davisjp1822/Analog_Persistence/README.md

# Analog_Persistence
Educational board showing an industrial 4-20mA or 0-10V input using a MCP3424 A/D and AD8220 Diffamp

Purchase the complete board at the [ThreeML website](https://www.three-ml.com/product/analog-persistence/)
