davisjp1822/Analog_Persistence/BOM.xlsx

Sheet: BOM
Reference | Value | Characteristics | Description | MFN | Package ID | Source | Critical | Notes | Populate | MPN | Library | Library Ref
C101 | 10uF | X | 10ÂµF Â±10% 16V Ceramic Capacitor X7R 0805 (2012 Metric) | Samsung Electro-Mechanics America Inc. | 805 | Digikey | Y | X |  | CL21B106KOQNNNG | device | C_Small
C102 | 10uF | X | 10ÂµF Â±10% 16V Ceramic Capacitor X7R 0805 (2012 Metric) | Samsung Electro-Mechanics America Inc. | 805 | Digikey | Y | X |  | CL21B106KOQNNNG | device | C_Small
C103 | 0.1uF | 0.1uF 0805 capacitor | 0.10ÂµF 50V Ceramic Capacitor X7R 0805 | AVX Corporation | 805 | Digikey | Y | X |  | 08055C104KAT2A | device | C_Small
C104 | 0.1uF | 0.1uF 0805 capacitor | 0.10ÂµF 50V Ceramic Capacitor X7R 0805 | AVX Corporation | 805 | Digikey | Y | X |  | 08055C104KAT2A | device | C_Small
C105 | 10uF | X | 10ÂµF Â±10% 16V Ceramic Capacitor X7R 0805 (2012 Metric) | Samsung Electro-Mechanics America Inc. | 805 | Digikey | Y | X |  | CL21B106KOQNNNG | device | C_Small
C106 | 10uF | X | F931A106KAA | AVX Corporation | 1206 (3216 Metric) | Digikey | Y | X | 1 |  | device | CP1_Small
C107 | 10uF | X | 10ÂµF Â±10% 16V Ceramic Capacitor X7R 0805 (2012 Metric) | Samsung Electro-Mechanics America Inc. | 805 | Digikey | Y | X |  | CL21B106KOQNNNG | device | C_Small
C108 | 10uF | X | 10ÂµF Â±10% 16V Ceramic Capacitor X7R 0805 (2012 Metric) | Samsung Electro-Mechanics America Inc. | 805 | Digikey | Y | X |  | CL21B106KOQNNNG | device | C_Small
C109 | 10uF | X | 10ÂµF Â±10% 16V Ceramic Capacitor X7R 0805 (2012 Metric) | Samsung Electro-Mechanics America Inc. | 805 | Digikey | Y | X |  | CL21B106KOQNNNG | device | C_Small
C110 | 0.1uF | 0.1uF 0805 capacitor | 0.10ÂµF 50V Ceramic Capacitor X7R 0805 | AVX Corporation | 805 | Digikey | Y | X |  | 08055C104KAT2A | device | C_Small
C111 | 0.1uF | 0.1uF 0805 capacitor | 0.10ÂµF 50V Ceramic Capacitor X7R 0805 | AVX Corporation | 805 | Digikey | Y | X |  | 08055C104KAT2A | device | C_Small
C112 | 0.1uF | 0.1uF 0805 capacitor | 0.10ÂµF 50V Ceramic Capacitor X7R 0805 | AVX Corporation | 805 | Digikey | Y | X |  | 08055C104KAT2A | device | C_Small
C113 | 0.1uF | 0.1uF 0805 capacitor | 0.10ÂµF 50V Ceramic Capacitor X7R 0805 | AVX Corporation | 805 | Digikey | Y | X |  | 08055C104KAT2A | device | C_Small
C114 | 0.1uF | 0.1uF 0805 capacitor | 0.10ÂµF 50V Ceramic Capacitor X7R 0805 | AVX Corporation | 805 | Digikey | Y | X |  | 08055C104KAT2A | device | C_Small
C115 | 0.1uF | 0.1uF 0805 capacitor | 0.10ÂµF 50V Ceramic Capacitor X7R 0805 | AVX Corporation | 805 | Digikey | Y | X |  | 08055C104KAT2A | device | C_Small
C116 | 0.1uF | 0.1uF 0805 capacitor | 0.10ÂµF 50V Ceramic Capacitor X7R 0805 | AVX Corporation | 805 | Digikey | Y | X |  | 08055C104KAT2A | device | C_Small
C117 | 0.1uF | 0.1uF 0805 capacitor | 0.10ÂµF 50V Ceramic Capacitor X7R 0805 | AVX Corporation | 805 | Digikey | Y | X |  | 08055C104KAT2A | device | C_Small
C118 | 1nF HV | X | CAP CER 1000PF 1KV X7R 0805 | Johanson Dielectrics Inc. | 805 | Digikey | Y | X | 1 | 102R15W102KV4E | device | C_Small
C119 | 1nF HV | X | CAP CER 1000PF 1KV X7R 0805 | Johanson Dielectrics Inc. | 805 | Digikey | Y | X | 1 | 102R15W102KV4E | device | C_Small
C120 | 1nF HV | X | CAP CER 1000PF 1KV X7R 0805 | Johanson Dielectrics Inc. | 805 | Digikey | Y | X | 1 | 102R15W102KV4E | device | C_Small
C121 | 1nF HV | X | CAP CER 1000PF 1KV X7R 0805 | Johanson Dielectrics Inc. | 805 | Digikey | Y | X | 1 | 102R15W102KV4E | device | C_Small
C122 | 10uF | X | 10ÂµF Â±10% 16V Ceramic Capacitor X7R 0805 (2012 Metric) | Samsung Electro-Mechanics America Inc. | 805 | Digikey | Y | X |  | CL21B106KOQNNNG | device | C_Small
D101 | D_Schottky_Small_ALT | X | Diode Schottky 30V 500mA (DC) Surface Mount SOD-323 | ON Semiconductor | SOD-323 | Digikey | Y | X |  | NSR0530HT1GOSCT-ND | device | D_Schottky_Small_ALT
D102 | D_Schottky_Small_ALT | X | Diode Schottky 30V 500mA (DC) Surface Mount SOD-323 | ON Semiconductor | SOD-323 | Digikey | Y | X |  | NSR0530HT1GOSCT-ND | device | D_Schottky_Small_ALT
D103 | D_Schottky_Small_ALT | X | Diode Schottky 30V 500mA (DC) Surface Mount SOD-323 | ON Semiconductor | SOD-323 | Digikey | Y | X |  | NSR0530HT1GOSCT-ND | device | D_Schottky_Small_ALT
D104 | D_Schottky_Small_ALT | X | Diode Schottky 30V 500mA (DC) Surface Mount SOD-323 | ON Semiconductor | SOD-323 | Digikey | Y | X |  | NSR0530HT1GOSCT-ND | device | D_Schottky_Small_ALT
D105 | D_Schottky_Small_ALT | X | Diode Schottky 30V 500mA (DC) Surface Mount SOD-323 | ON Semiconductor | SOD-323 | Digikey | Y | X |  | NSR0530HT1GOSCT-ND | device | D_Schottky_Small_ALT
D106 | D_Schottky_Small_ALT | X | Diode Schottky 30V 500mA (DC) Surface Mount SOD-323 | ON Semiconductor | SOD-323 | Digikey | Y | X |  | NSR0530HT1GOSCT-ND | device | D_Schottky_Small_ALT
D107 | SMBJ20CA | X | TVS Diode | Littelfuse Inc | DO-214AA | Digikey | Y | X |  | SMBJ20CALFCT-ND | 3ML_LLC_Component_Library | TVS_Small
D108 | SMBJ20CA | X | TVS Diode | Littelfuse Inc | DO-214AA | Digikey | Y | X |  | SMBJ20CALFCT-ND | 3ML_LLC_Component_Library | TVS_Small
D109 | SMBJ20CA | X | TVS Diode | Littelfuse Inc | DO-214AA | Digikey | Y | X |  | SMBJ20CALFCT-ND | 3ML_LLC_Component_Library | TVS_Small
D110 | SMBJ20CA | X | TVS Diode | Littelfuse Inc | DO-214AA | Digikey | Y | X |  | SMBJ20CALFCT-ND | 3ML_LLC_Component_Library | TVS_Small
D111 | D_Schottky_Small_ALT | X | Diode Schottky 30V 500mA (DC) Surface Mount SOD-323 | ON Semiconductor | SOD-323 | Digikey | Y | X |  | NSR0530HT1GOSCT-ND | device | D_Schottky_Small_ALT
D112 | D_Schottky_Small_ALT | X | Diode Schottky 30V 500mA (DC) Surface Mount SOD-323 | ON Semiconductor | SOD-323 | Digikey | Y | X |  | NSR0530HT1GOSCT-ND | device | D_Schottky_Small_ALT
D113 | D_Schottky_Small_ALT | X | Diode Schottky 30V 500mA (DC) Surface Mount SOD-323 | ON Semiconductor | SOD-323 | Digikey | Y | X |  | NSR0530HT1GOSCT-ND | device | D_Schottky_Small_ALT
D114 | D_Schottky_Small_ALT | X | Diode Schottky 30V 500mA (DC) Surface Mount SOD-323 | ON Semiconductor | SOD-323 | Digikey | Y | X |  | NSR0530HT1GOSCT-ND | device | D_Schottky_Small_ALT
J101 | CONN_01X04 | X | 1x4 0.100 PITCH PIN HEADER | Harwin | TH | Digikey | Y | X | 1 | M20-9990445 | conn | CONN_01X04
J102 | CONN_01X08 | X | 8 Position Wire to Board Terminal Block Horizontal with Board 0.197" (5.00mm) Through Hole | Phoenix Contact | TH | Digikey | Y | X |  | 1935226 | conn | CONN_01X08
JP101 | INPUT SELECT | X | 3 Positions Header Unshrouded Connector 0.050" (1.27mm) Surface Mount Gold | Sullins Connector Solutions | X | Digikey | Y | X |  | GRPB031VWTC-RC | device | Jumper_NC_Dual
JP102 | INPUT SELECT | X | 3 Positions Header Unshrouded Connector 0.050" (1.27mm) Surface Mount Gold | Sullins Connector Solutions | X | Digikey | Y | X |  | GRPB031VWTC-RC | device | Jumper_NC_Dual
JP103 | INPUT SELECT | X | 3 Positions Header Unshrouded Connector 0.050" (1.27mm) Surface Mount Gold | Sullins Connector Solutions | X | Digikey | Y | X |  | GRPB031VWTC-RC | device | Jumper_NC_Dual
JP104 | INPUT SELECT | X | 3 Positions Header Unshrouded Connector 0.050" (1.27mm) Surface Mount Gold | Sullins Connector Solutions | X | Digikey | Y | X |  | GRPB031VWTC-RC | device | Jumper_NC_Dual
R101 | 0 | X | RES SMD 0.0 OHM JUMPER 1/8W 0805 | Yageo | 805 | Digikey | Y | X |  | RC0805JR-070RL | device | R
R102 | 0 | X | RES SMD 0.0 OHM JUMPER 1/8W 0805 | Yageo | 805 | Digikey | Y | X |  | RC0805JR-070RL | device | R
R103 | 1M | X | RES SMD 1M OHM 5% 1/8W 0805 | Stackpole Electronics Inc. | 805 | Digikey | Y | X | 1 | RMCF0805JT1M00 | device | R
R104 | 1M | X | RES SMD 1M OHM 5% 1/8W 0805 | Stackpole Electronics Inc. | 805 | Digikey | Y | X | 1 | RMCF0805JT1M00 | device | R
R105 | 1M | X | RES SMD 1M OHM 5% 1/8W 0805 | Stackpole Electronics Inc. | 805 | Digikey | Y | X | 1 | RMCF0805JT1M00 | device | R
R106 | 1M | X | RES SMD 1M OHM 5% 1/8W 0805 | Stackpole Electronics Inc. | 805 | Digikey | Y | X | 1 | RMCF0805JT1M00 | device | R
R107 | 54.9 | Valuex | RES SMD 54.9K OHM 0.1% 1/8W 0805 | Panasonic Electronic Company | 805 | Digikey | Y | X |  | ERA-6AEB5492V | device | R
R108 | 54.9 | Valuex | RES SMD 54.9K OHM 0.1% 1/8W 0805 | Panasonic Electronic Company | 805 | Digikey | Y | X |  | ERA-6AEB5492V | device | R
R109 | 54.9 | Valuex | RES SMD 54.9K OHM 0.1% 1/8W 0805 | Panasonic Electronic Company | 805 | Digikey | Y | X |  | ERA-6AEB5492V | device | R
R110 | 54.9 | Valuex | RES SMD 54.9K OHM 0.1% 1/8W 0805 | Panasonic Electronic Company | 805 | Digikey | Y | X |  | ERA-6AEB5492V | device | R
R111 | 221K | X | RES SMD 220K OHM 0.1% 1/8W 0805 | Panasonic Electronic Corporation | 805 | Digikey | Y | X |  | ERA-6AEB2213V | device | R
R112 | 221K | X | RES SMD 220K OHM 0.1% 1/8W 0805 | Panasonic Electronic Corporation | 805 | Digikey | Y | X |  | ERA-6AEB2213V | device | R
R113 | 221K | X | RES SMD 220K OHM 0.1% 1/8W 0805 | Panasonic Electronic Corporation | 805 | Digikey | Y | X |  | ERA-6AEB2213V | device | R
R114 | 221K | X | RES SMD 220K OHM 0.1% 1/8W 0805 | Panasonic Electronic Corporation | 805 | Digikey | Y | X |  | ERA-6AEB2213V | device | R
R115 | 100 | X | RES SMD 100 OHM 0.1% 5/8W 0805 | Vishay Thin Film | 805 | Digikey | Y | X |  | PHP00805E1000BST1 | device | R
R116 | 100 | X | RES SMD 100 OHM 0.1% 5/8W 0805 | Vishay Thin Film | 805 | Digikey | Y | X |  | PHP00805E1000BST1 | device | R
R117 | 100 | X | RES SMD 100 OHM 0.1% 5/8W 0805 | Vishay Thin Film | 805 | Digikey | Y | X |  | PHP00805E1000BST1 | device | R
R118 | 100 | X | RES SMD 100 OHM 0.1% 5/8W 0805 | Vishay Thin Film | 805 | Digikey | Y | X |  | PHP00805E1000BST1 | device | R
TP103 | TEST -5V | X | TEST POINT PC MINI .040"D RED | Keystone Electronics | TH | Digikey | Y | X |  | 5000 | device | TEST
TP104 | TEST VOUT1 | X | TEST POINT PC MINI .040"D RED | Keystone Electronics | TH | Digikey | Y | X |  | 5000 | device | TEST
TP105 | TEST IN- | X | TEST POINT PC MINI .040"D RED | Keystone Electronics | TH | Digikey | Y | X |  | 5000 | device | TEST
TP106 | TEST IN+ | X | TEST POINT PC MINI .040"D RED | Keystone Electronics | TH | Digikey | Y | X |  | 5000 | device | TEST
U101 | MCP3424 | X | 18 Bit Analog to Digital Converter 4 Input 1 Sigma-Delta 14-SOIC | Microchip Technology | 14-SOIC | Digikey | Y | X |  | MCP3424-E/SL | 3ML_LLC_Component_Library | MCP3424
U102 | ICL7660S A | X | IC REG SWTCHD CAP INV 45MA 8SOIC | Intersil | 8-SOIC | Digikey | Y | X | 1 | ICL7660AIBAZA | 3ML_LLC_Component_Library | ICL7660S
U103 | AD8220 | X | Instrumentation Amplifier 1 Circuit Rail-to-Rail 8-MSOP | Analog Devices Inc | 8-TSSOP | Digikey | Y | X |  | AD8220ARMZ | 3ML_LLC_Component_Library | AD8220
U104 | AD8220 | X | Instrumentation Amplifier 1 Circuit Rail-to-Rail 8-MSOP | Analog Devices Inc | 8-TSSOP | Digikey | Y | X |  | AD8220ARMZ | 3ML_LLC_Component_Library | AD8220
U105 | AD8220 | X | Instrumentation Amplifier 1 Circuit Rail-to-Rail 8-MSOP | Analog Devices Inc | 8-TSSOP | Digikey | Y | X |  | AD8220ARMZ | 3ML_LLC_Component_Library | AD8220
U106 | AD8220 | X | Instrumentation Amplifier 1 Circuit Rail-to-Rail 8-MSOP | Analog Devices Inc | 8-TSSOP | Digikey | Y | X |  | AD8220ARMZ | 3ML_LLC_Component_Library | AD8220

Sheet: PivotTable for OctoPart
Row Labels | Count of MPN
08055C104KAT2A | 10
NSR0530HT1GOSCT-ND | 10
CL21B106KOQNNNG | 7
AD8220ARMZ | 4
102R15W102KV4E | 4
GRPB031VWTC-RC | 4
RMCF0805JT1M00 | 4
PHP00805E1000BST1 | 4
SMBJ20CALFCT-ND | 4
5000 | 4
ERA-6AEB2213V | 4
ERA-6AEB5492V | 4
RC0805JR-070RL | 2
ICL7660AIBAZA | 1
M20-9990445 | 1
MCP3424-E/SL | 1
1935226 | 1
(blank)
Grand Total | 69
