davisjp1822/Analog_Persistence/rpi-industrial-analog.kicad_pcb

## KiCad design rpi-industrial-analog.kicad_pcb (2017-09-05)

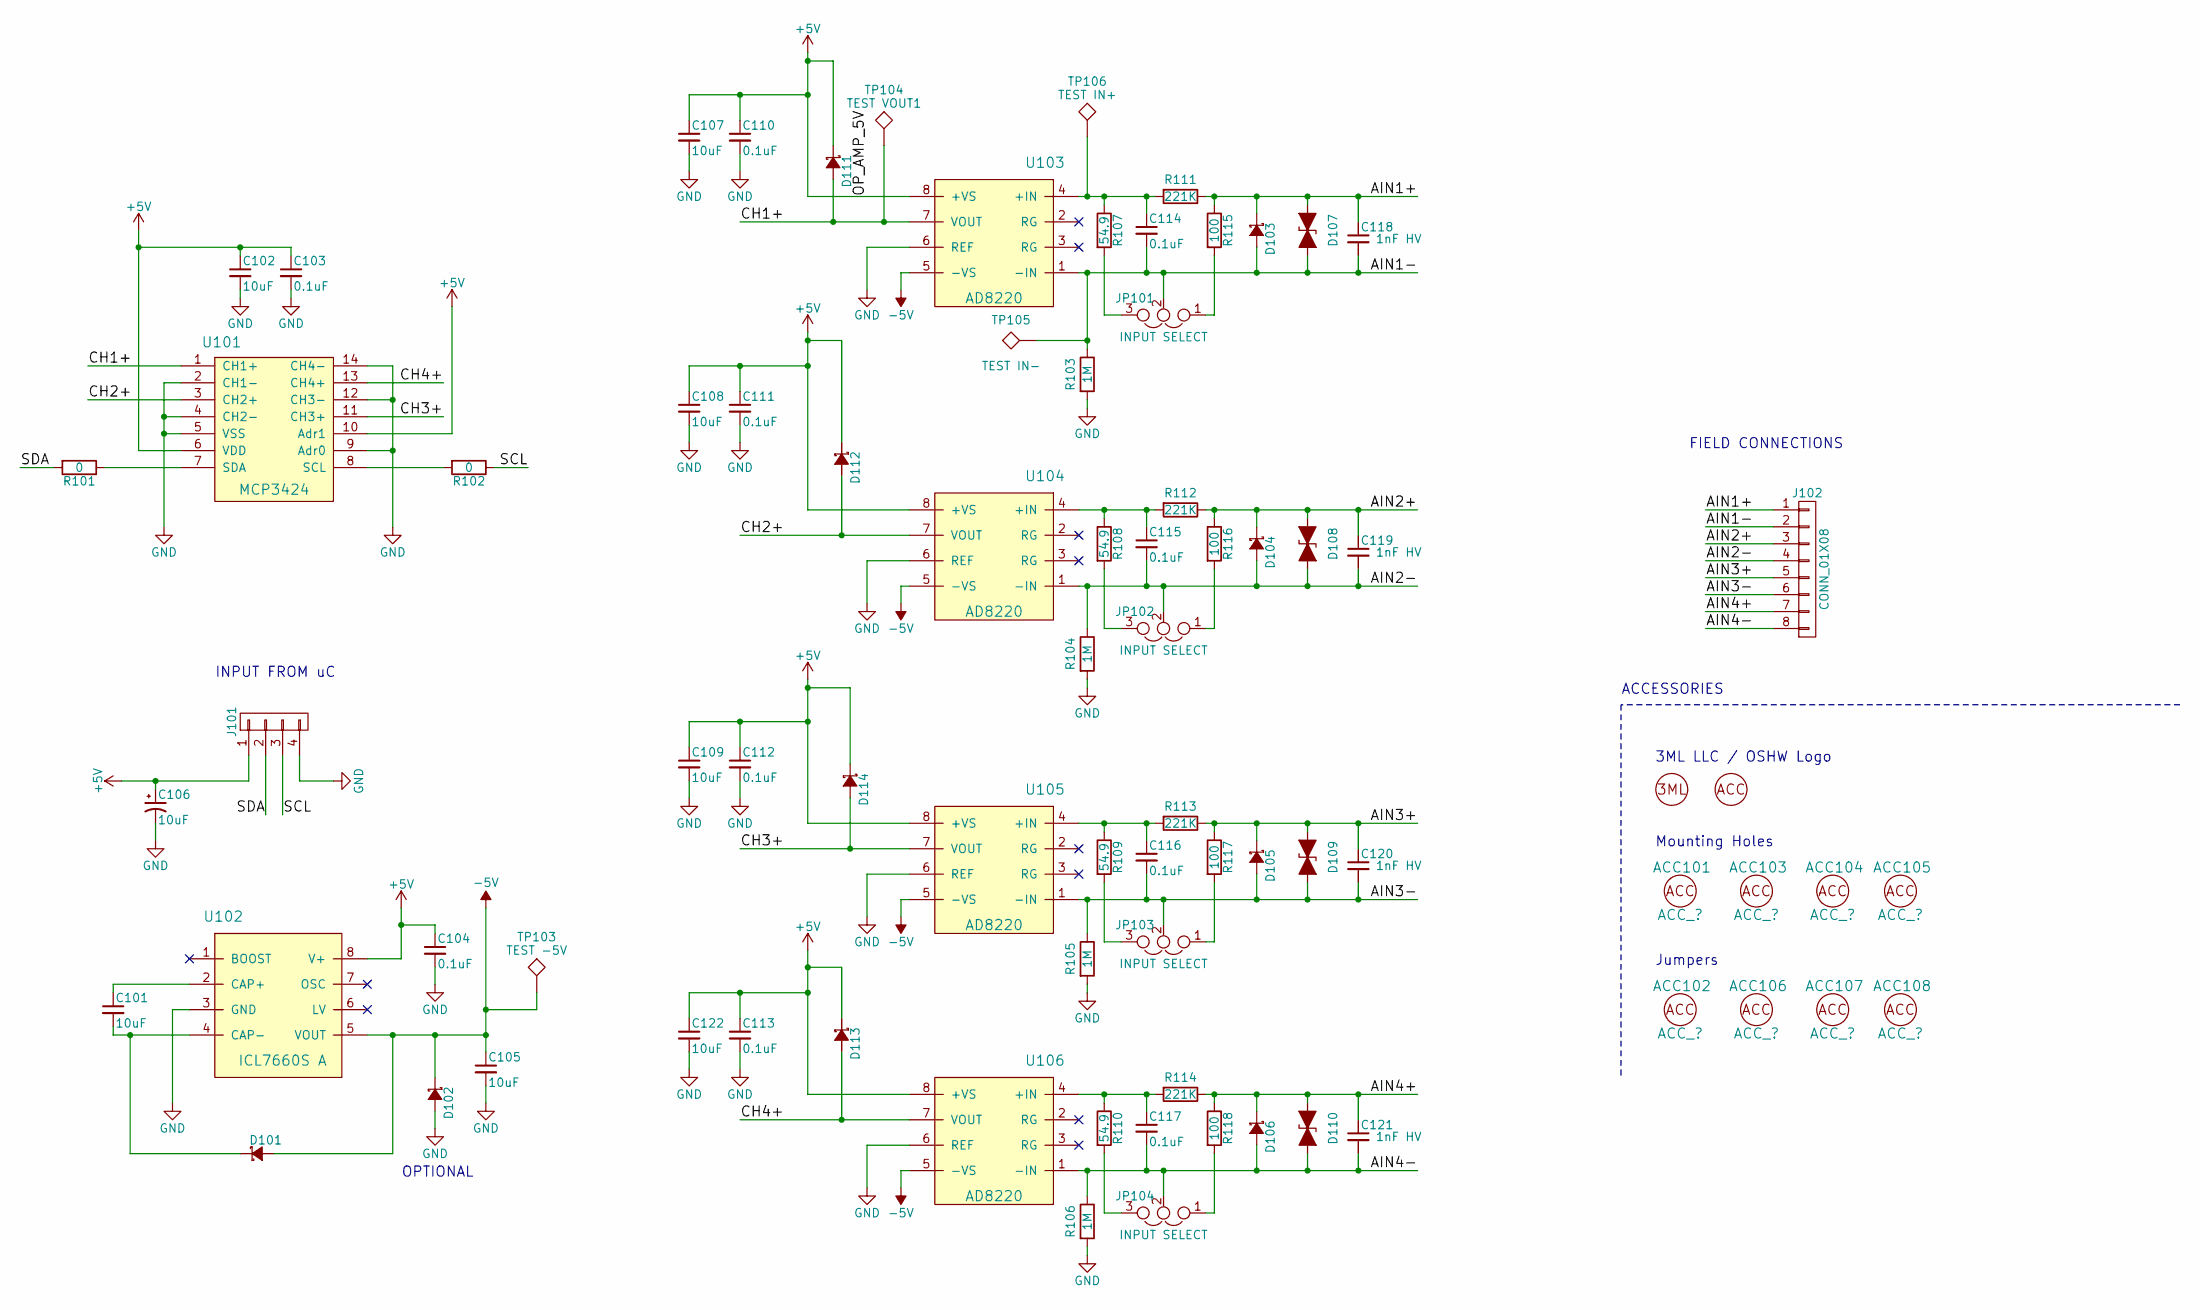
[picture p1: schematic rpi-industrial-analog.sch, Analog Persistence v1.0]

Parts:
ACC101, ACC103, ACC104, ACC105: ACC_?; MountingHole_3.2mm_M3_DIN965; MPN X
ACC102, ACC106, ACC107, ACC108: ACC_?; X; MPN NPB02SVAN-RC
ACC109: ACC_?; OSHW-Logo_11.4x12mm_SilkScreen
C101, C102, C105, C107, C108, C109, C122: 10uF; C_0805; MPN CL21B106KOQNNNG
C103, C104, C110, C111, C112, C113, C114, C115, C116, C117: 0.1uF; C_0805; MPN 08055C104KAT2A
C106: 10uF; CP_Tantalum_Case-A_EIA-3216-18_Reflow; MPN F931A106KAA
C118, C119, C120, C121: 1nF HV; C_0805; MPN 102R15W102KV4E
D101, D102, D103, D104, D105, D106, D111, D112, D113, D114: D_Schottky_Small_ALT; D_SOD-323; MPN NSR0530HT1GOSCT-ND
D107, D108, D109, D110: SMBJ20CA; DO-214AA_Hand_Soldering; MPN SMBJ20CALFCT-ND
J101: CONN_01X04; Pin_Header_Straight_1x04_Pitch2.54mm; MPN M20-9990445
J102: CONN_01X08; Phoenix-1x8-1935226; MPN 1935226
JP101, JP102, JP103, JP104: INPUT SELECT; Sullins-1x3-Jumper-GRPB031VWTC-RC; MPN GRPB031VWTC-RC
LG101: 3ML_LOGO; MPN X
R101, R102: 0; R_0805; MPN ValueRC0805JR-070RL
R103, R104, R105, R106: 1M; R_0805; MPN RMCF0805JT1M00
R107, R108, R109, R110: 54.9; R_0805; MPN ERA-6AEB5492V
R111, R112, R113, R114: 221K; R_0805; MPN ERA-6AEB2213V
R115, R116, R117, R118: 100; R_0805; MPN PHP00805E1000BST1
TP103: TEST -5V; Keystone_5000_Test_Point_Mini; MPN 5000
TP104: TEST VOUT1; Keystone_5000_Test_Point_Mini; MPN 5000
TP105: TEST IN-; Keystone_5000_Test_Point_Mini; MPN 5000
TP106: TEST IN+; Keystone_5000_Test_Point_Mini; MPN 5000
U101: MCP3424; SOIC-14_3.9x8.7mm_Pitch1.27mm; MPN MCP3424-E/SL
U102: ICL7660S A; SOIC-8_3.9x4.9mm_Pitch1.27mm; MPN ICL7660AIBAZA
U103, U104, U105, U106: AD8220; MSOP-8_3x3mm_Pitch0.65mm; MPN AD8220ARMZ

Connections:
+5V: C102.1, C103.1, C104.1, C106.1, C107.1, C108.1, C109.1, C110.1, C111.1, C112.1, C113.1, C122.1, D111.1 (K), D112.1 (K), D113.1 (K), D114.1 (K), J101.1, U101.6 (VDD), U101.10 (Adr1), U102.8 (V+), U103.8 (+VS), U104.8 (+VS), U105.8 (+VS), U106.8 (+VS)
-5V: C105.1, D101.2 (A), D102.1 (K), TP103.1, U102.5 (VOUT), U103.5 (-VS), U104.5 (-VS), U105.5 (-VS), U106.5 (-VS); also elsewhere on the board
/AIN1+: C118.1, D103.1 (K), D107.1 (A1), J102.1, R111.1, R115.1
/AIN1-: C114.2, C118.2, D103.2 (A), D107.2 (A2), J102.2, JP101.2, R103.1, TP105.1, U103.1 (-IN); also elsewhere on the board
/AIN2+: C119.1, D104.1 (K), D108.1 (A1), J102.3, R112.1, R116.1
/AIN2-: C115.2, C119.2, D104.2 (A), D108.2 (A2), J102.4, JP102.2, R104.1, U104.1 (-IN)
/AIN3+: C120.1, D105.1 (K), D109.1 (A1), J102.5, R113.1, R117.1
/AIN3-: C116.2, C120.2, D105.2 (A), D109.2 (A2), J102.6, JP103.2, R105.1, U105.1 (-IN)
/AIN4+: C121.1, D106.1 (K), D110.1 (A1), J102.7, R114.1, R118.1
/AIN4-: C117.2, C121.2, D106.2 (A), D110.2 (A2), J102.8, JP104.2, R106.1, U106.1 (-IN)
/CH1+: D111.2 (A), TP104.1, U101.1 (CH1+), U103.7 (VOUT); also elsewhere on the board
/CH2+: D112.2 (A), U101.3 (CH2+), U104.7 (VOUT)
/CH3+: D114.2 (A), U101.11 (CH3+), U105.7 (VOUT)
/CH4+: D113.2 (A), U101.13 (CH4+), U106.7 (VOUT)
/SCL: J101.3, R102.1
/SDA: J101.2, R101.2
GND: C102.2, C103.2, C104.2, C105.2, C106.2, C107.2, C108.2, C109.2, C110.2, C111.2, C112.2, C113.2, C122.2, D102.2 (A), J101.4, R103.2, R104.2, R105.2, R106.2, U101.2 (CH1-), U101.4 (CH2-), U101.5 (VSS), U101.9 (Adr0), U101.12 (CH3-), U101.14 (CH4-), U102.3 (GND), U103.6 (REF), U104.6 (REF), U105.6 (REF), U106.6 (REF)
unnamed: C101.1, U102.2 (CAP+)
unnamed: C101.2, D101.1 (K), U102.4 (CAP-)
unnamed 19: C114.1, R107.1, R111.2, TP106.1, U103.4 (+IN); also elsewhere on the board
unnamed: C115.1, R108.1, R112.2, U104.4 (+IN)
unnamed: C116.1, R109.1, R113.2, U105.4 (+IN)
unnamed: C117.1, R110.1, R114.2, U106.4 (+IN)
unnamed: JP101.1, R115.2
unnamed: JP101.3, R107.2
unnamed: JP102.1, R116.2
unnamed: JP102.3, R108.2
unnamed: JP103.1, R117.2
unnamed: JP103.3, R109.2
unnamed: JP104.1, R118.2
unnamed: JP104.3, R110.2
unnamed: R101.1, U101.7 (SDA)
unnamed: R102.2, U101.8 (SCL)

Notes on the sheet:
INPUT FROM uC
FIELD CONNECTIONS
OPTIONAL
3ML LLC / OSHW Logo
ACCESSORIES
Mounting Holes
Jumpers

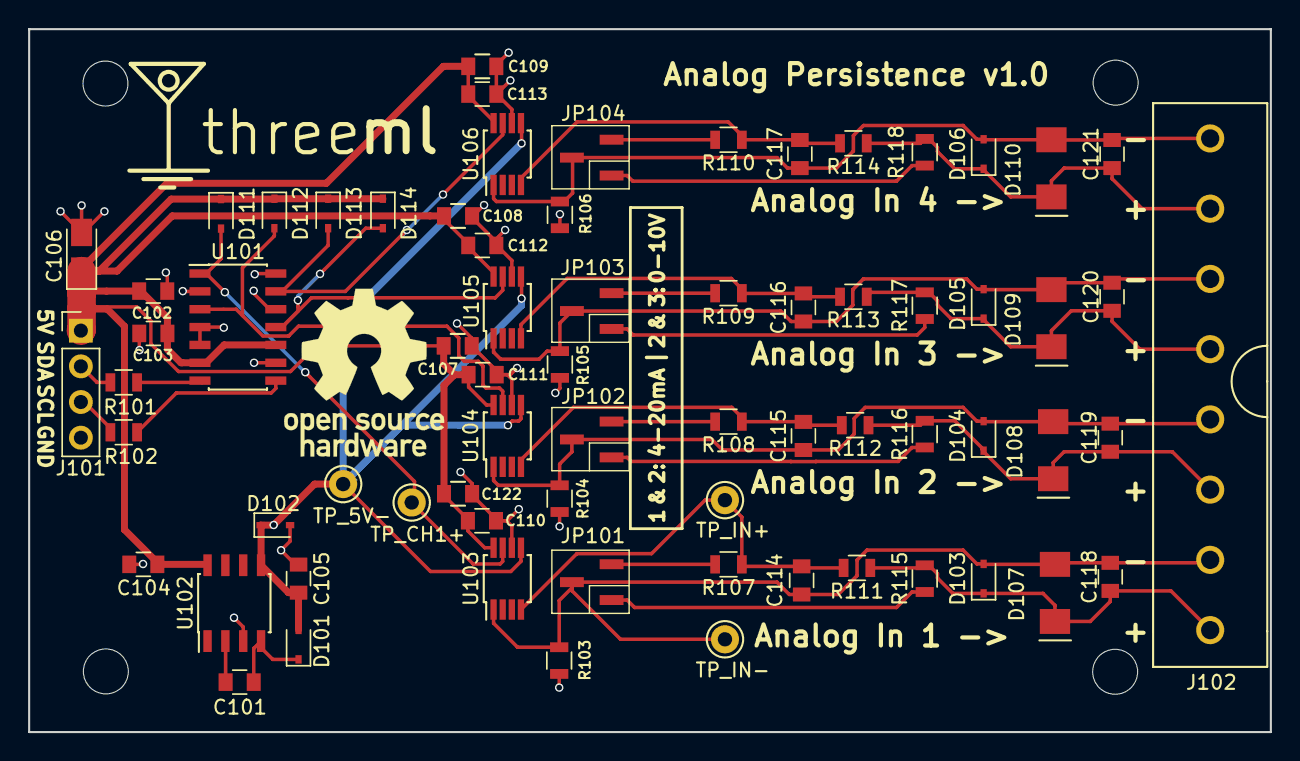
[picture p2: board rpi-industrial-analog.kicad_pcb from above]

Board: 2 copper layers, 88.4 x 50.0 mm, 76 parts (0 on the bottom side), 33 nets.

Other parts of the board:
TP_5V-: TEST -5V; Keystone_5000_Test_Point_Mini
TP_CH1+: TEST VOUT1; Keystone_5000_Test_Point_Mini
TP_IN+: TEST IN+; Keystone_5000_Test_Point_Mini
TP_IN-: TEST IN-; Keystone_5000_Test_Point_Mini

Their connections:
-5V: TP_5V-.1; also elsewhere on the board
/AIN1-: TP_IN-.1; also elsewhere on the board
/CH1+: TP_CH1+.1; also elsewhere on the board
unnamed 19: TP_IN+.1; also elsewhere on the board
