davisjp1822/Analog_Persistence/(commit log)

2017-03-27 First Commit
    Adding files, getting ready to start board layout
    [rpi-industrial-analog.kicad_pcb, rpi-industrial-analog.sch]
2017-03-28 Layout complete
    [rpi-industrial-analog.kicad_pcb, rpi-industrial-analog.sch]
2017-03-28 adding logos and mounting holes
    [rpi-industrial-analog.kicad_pcb, rpi-industrial-analog.sch]
2017-03-29 fixing some routing errors
    [rpi-industrial-analog.kicad_pcb]
2017-03-29 fixing some silk screen issues
    [rpi-industrial-analog.kicad_pcb]
2017-03-29 added 3d file for phoenix connector
    [rpi-industrial-analog.kicad_pcb]
2017-08-01 revised board for production and added 1M caps so that this thing works
    [rpi-industrial-analog.kicad_pcb, rpi-industrial-analog.sch]
2017-08-02 adding gerbers, fixing DRC, adding overvoltage diodes to MCP inputs
    [rpi-industrial-analog-B.Cu.gbr, rpi-industrial-analog-B.Mask.gbr, rpi-industrial-analog-B.Paste.gbr, rpi-industrial-analog-B.SilkS.gbr, rpi-industrial-analog-Edge.Cuts.gbr, rpi-industrial-analog-F.Cu.gbr, rpi-industrial-analog-F.Mask.gbr, rpi-industrial-analog-F.Paste.gbr]
2017-08-07 cleaning-up Gerbers and step 1 of migrating footprints to master 3ML library
    [BOM.xlsx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]
2017-08-07 adding master footprint library as submodule
2017-08-07 schematic library switched to master library
    [rpi-industrial-analog.sch]
2017-08-07 updating footprints to use master library
    [rpi-industrial-analog.kicad_pcb, rpi-industrial-analog.sch]
2017-09-05 kicad version bump updating files
    [rpi-industrial-analog.kicad_pcb, rpi-industrial-analog.sch]
2018-06-11 updating kicad version
    [rpi-industrial-analog.kicad_pcb, rpi-industrial-analog.sch]
