davisjp1822/Analog_Persistence/(notices)

Notices in the files:
rpi-industrial-analog.sch:
Licensed under the GPL v3
